m2i/EggDrop_Accelerometer/4-Enclosure/Egg.stl

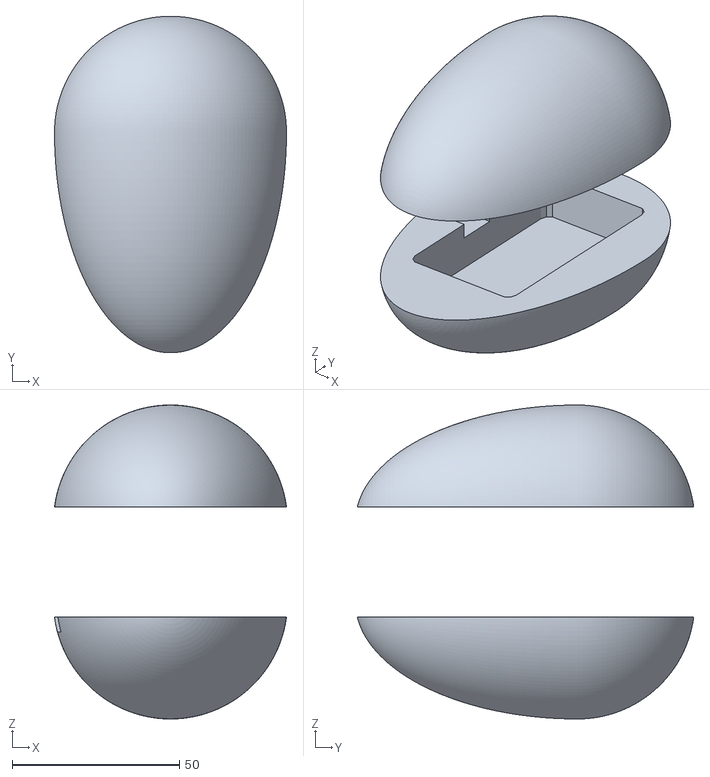
[picture p1: CAD file, 2017-08-26]
4-Enclosure/Egg.stl
69.4 x 100.6 x 93.9
