m2i/EggDrop_Accelerometer/4-Enclosure/egg_drop.stl

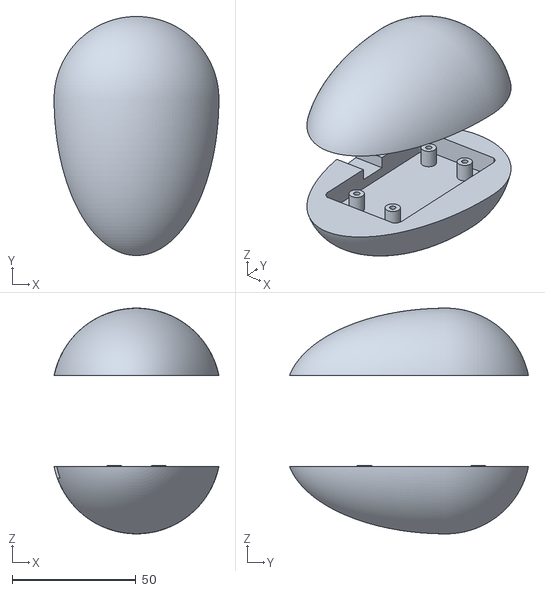
[picture p2: CAD file, 2017-07-11]
4-Enclosure/egg_drop.stl
66.6 x 96.6 x 91.2
