m2i/EggDrop_Accelerometer/(list of files, drawings)

Other design files:
2-Hardware/egg_feather_brd.dsn
