m2i/EggDrop_Accelerometer/2-Hardware/egg_feather_brd.kicad_pcb

## KiCad design 2-Hardware/egg_feather_brd.kicad_pcb (2017-07-11)

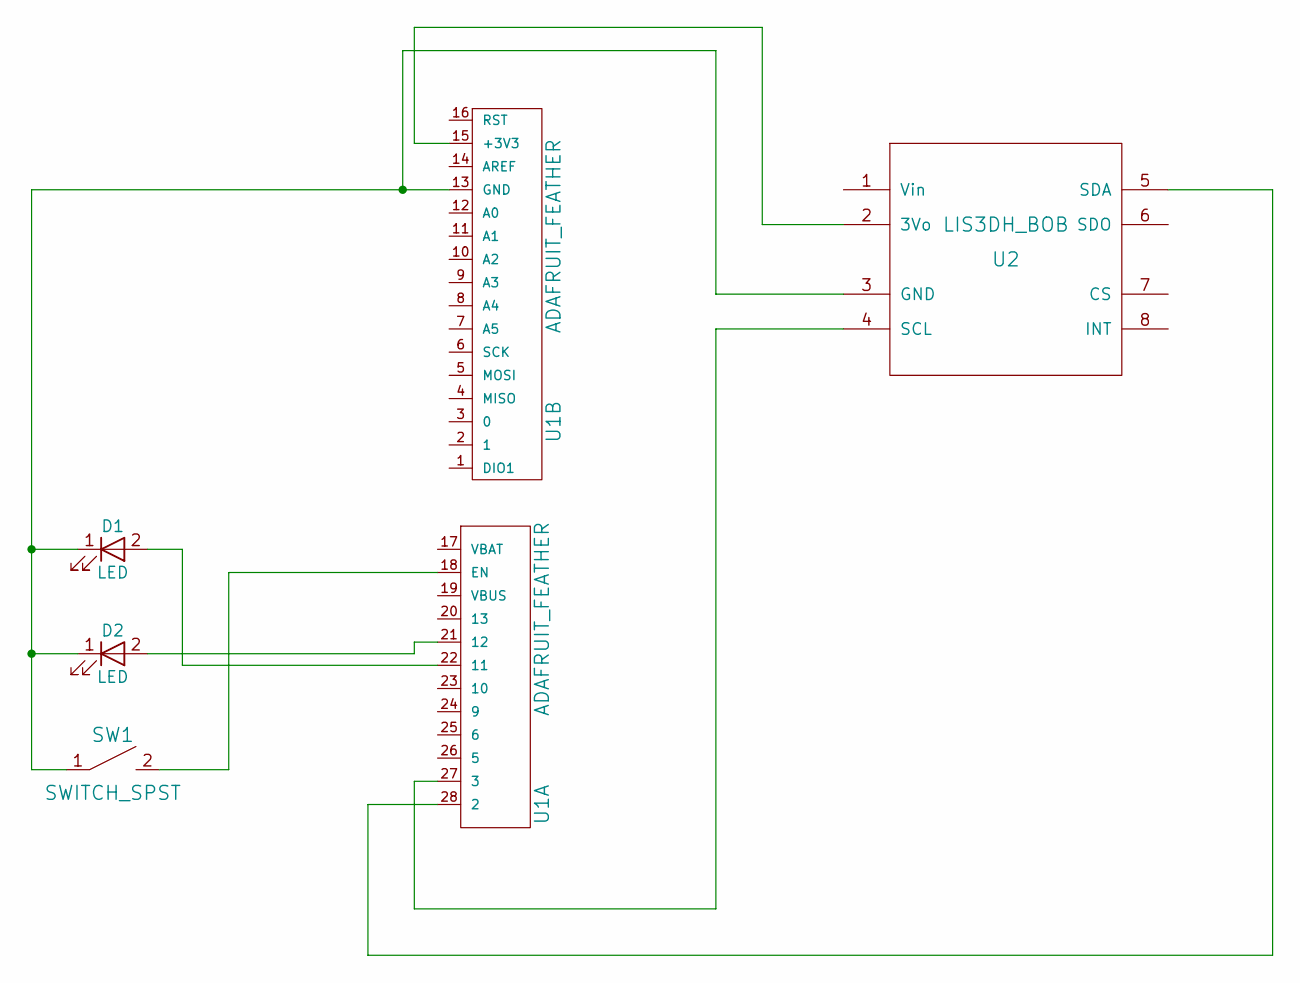
[picture p3: schematic egg_feather_brd.sch, Egg Drop Feather Board]

Parts:
D1, D2: LED; LED_D5.0mm
SW1: SWITCH_SPST; SW_DIP_x1_W7.62mm_Slide
U1: ADAFRUIT_FEATHER
U2: LIS3DH_BOB; Pin_Header_Straight_1x08_Pitch2.54mm

Connections:
unnamed: D1.1 (K), D2.1 (K), SW1.1, U1.13 (GND), U2.3 (GND)
unnamed: D1.2 (A), U1.22 (11)
unnamed: D2.2 (A), U1.21 (12)
unnamed: SW1.2, U1.18 (EN)
unnamed: U1.15 (+3V3), U2.2 (3Vo)
unnamed: U1.27 (3), U2.4 (SCL)
unnamed: U1.28 (2), U2.5 (SDA)

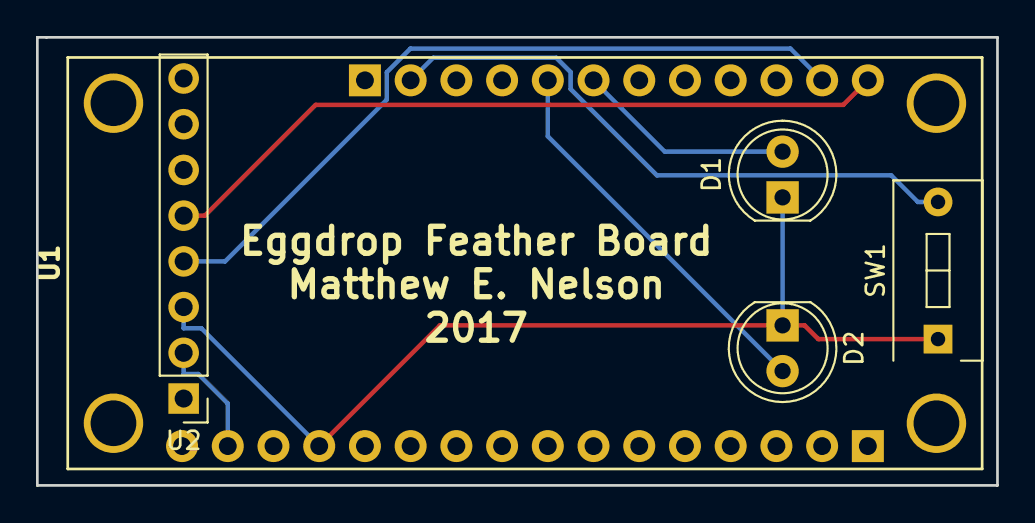
[picture p4: board egg_feather_brd.kicad_pcb from above]

Board: 2 copper layers, 53.3 x 24.9 mm, 5 parts (0 on the bottom side), 7 nets.
