m2i/EggDrop_Accelerometer/(commit log)

2013-09-21 Added the hardware layout files for the EggDrop board.
    [ISU_EggDrop-RevC-BoM.csv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]
2013-09-21 MATLAB script to parse logged data from the accelerometer.
2014-09-03 Added enclosure files
    [Egg.scad, Egg.stl, Eggv2.stl]
2014-09-05 Update to enclosure
    Minor changes based on prototype egg printed
    [Egg.scad, Eggv2.stl]
2014-09-07 Update
    Update to T-lock based on recent 3D print test.
    [Egg.scad, Eggv2.stl]
2015-06-11 Update
    Update to new part for 3D printed egg
    [Egg.scad, Egg.stl]
2015-06-15 Final edit
    Final edit to new enclosure for a test print.
    [Egg.scad, Egg.stl]
2015-08-06 Minor change to 3D enclosure
    [Egg.scad, Egg.stl]
2015-08-06 Added light pipe
    Added cutout for light pipe
    [Egg.scad, Egg.stl]
2015-08-07 Minor adjustments
    Minor update to placement of the light pipe, changed thickness on
    T-lock for more secure lock. Deleted old STL.
    [Egg.stl, Eggv2.stl]
2015-08-07 Update
    The actual update to the file.
    [Egg.scad]
2016-08-28 First version
    First compilable version with sensor read and wrting to the SD Card
2016-08-28 Revision 1 code
    Working code, compiles and runs as expected on Feather board.
2016-08-28 Updated eclosure
    Updated enclosure to match new hardware. Had to get rid of the T-locks,
    not enough room.
    [Egg.scad, Egg.stl]
2016-09-01 Fixed errors
    Fixed calculation error in magnitude. Decreased sensitivity for
    triggering broken egg.
    [Egg.scad]
2017-06-30 New featherboard shield
    [ISU_EggDrop-RevC-BoM.csv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]
2017-07-07 Changed to BOB circuit
    [egg_feather_brd.sch]
2017-07-09 Revamp on enclosure, added first run PCB board
    Revamped the enclosure for test print. Added PCB based on circuit for
    first run boards for testing.
    [Egg.scad, egg_feather_brd.dsn, egg_feather_brd.sch]
2017-07-10 Moved part off pin 13 to pin 11
    Moved part off pin 13, new part placement on board
    [egg_feather_brd.kicad_pcb, egg_feather_brd.sch]
2017-07-11 Final revisions to board, routed
    Final design for first run. Board routed and sent to manufacturing.
    [egg_feather_brd.dsn, egg_feather_brd.kicad_pcb]
2017-07-11 update to enclosure
    Added mounting holes, ready for test print
    [egg_drop.stl, standoffs.scad]
2017-08-26 Updates to egg
    [Egg.stl]
2017-08-26 fix to battery voltage reading
    [Feather_FW.ino]
